SeeedDocument/Seeeduino_Arch/img/Open_Compiler.jpg

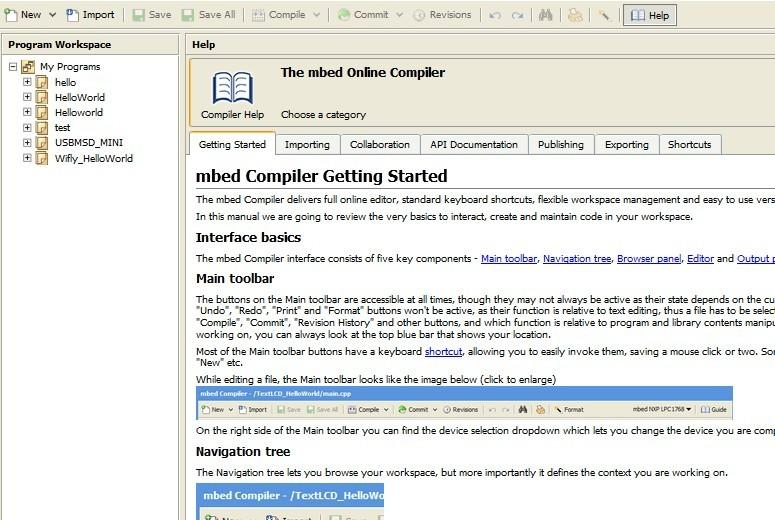
img/Open_Compiler.jpg
