SeeedDocument/Seeeduino_Arch/img/Arch_01.jpg

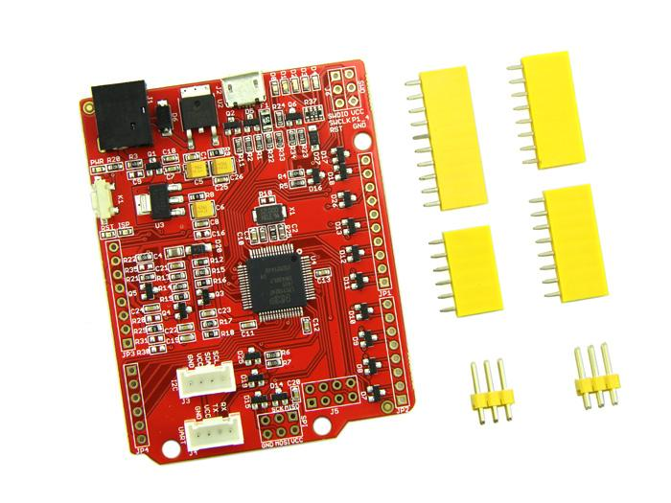
img/Arch_01.jpg
