SeeedDocument/Seeeduino_Arch/img/A_usb_device.jpg

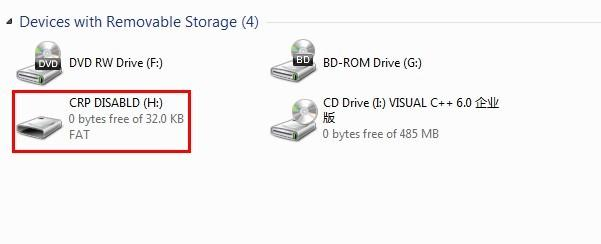
img/A_usb_device.jpg
