SeeedDocument/Seeeduino_Arch/img/Arch_Pinout.png

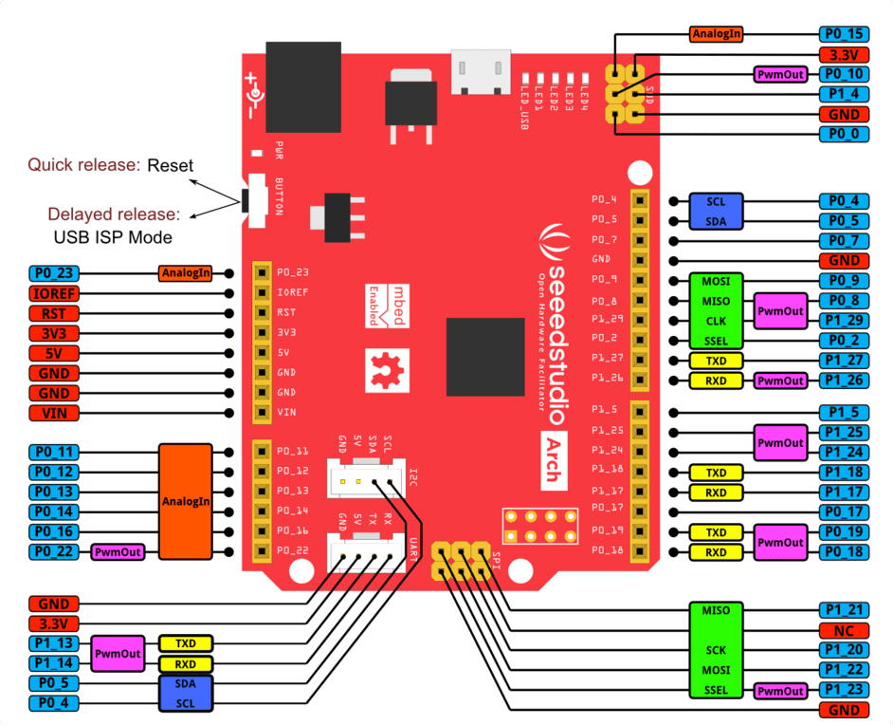
img/Arch_Pinout.png
