SeeedDocument/Seeeduino_Arch/img/Compiler.jpg

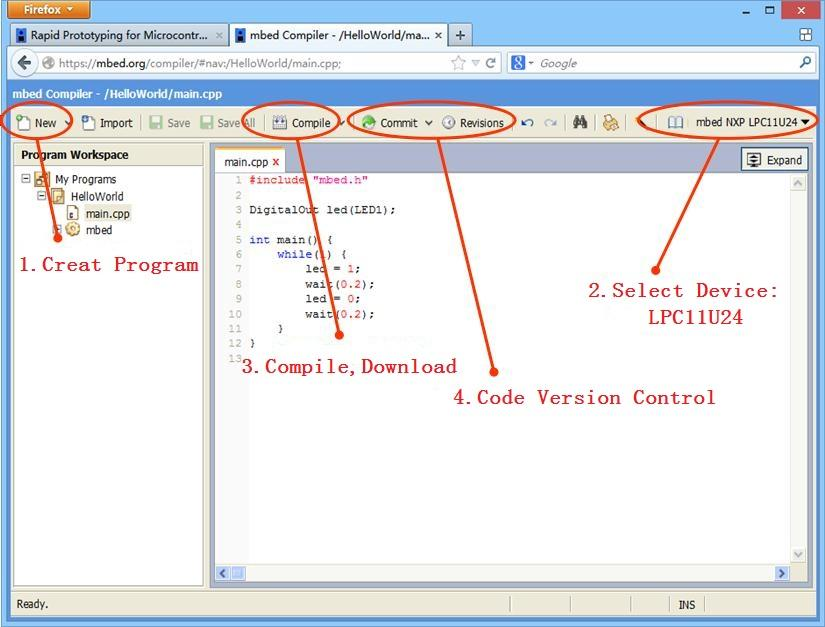
img/Compiler.jpg
