SeeedDocument/Seeeduino_Arch/img/Error_prompt.jpg

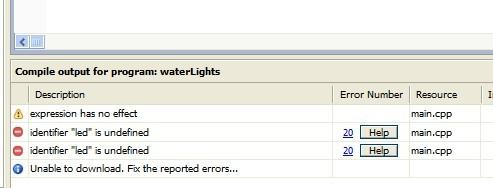
img/Error_prompt.jpg
