SeeedDocument/Seeeduino_Arch/res/Seeeduino_Arch_V1.0.pdf

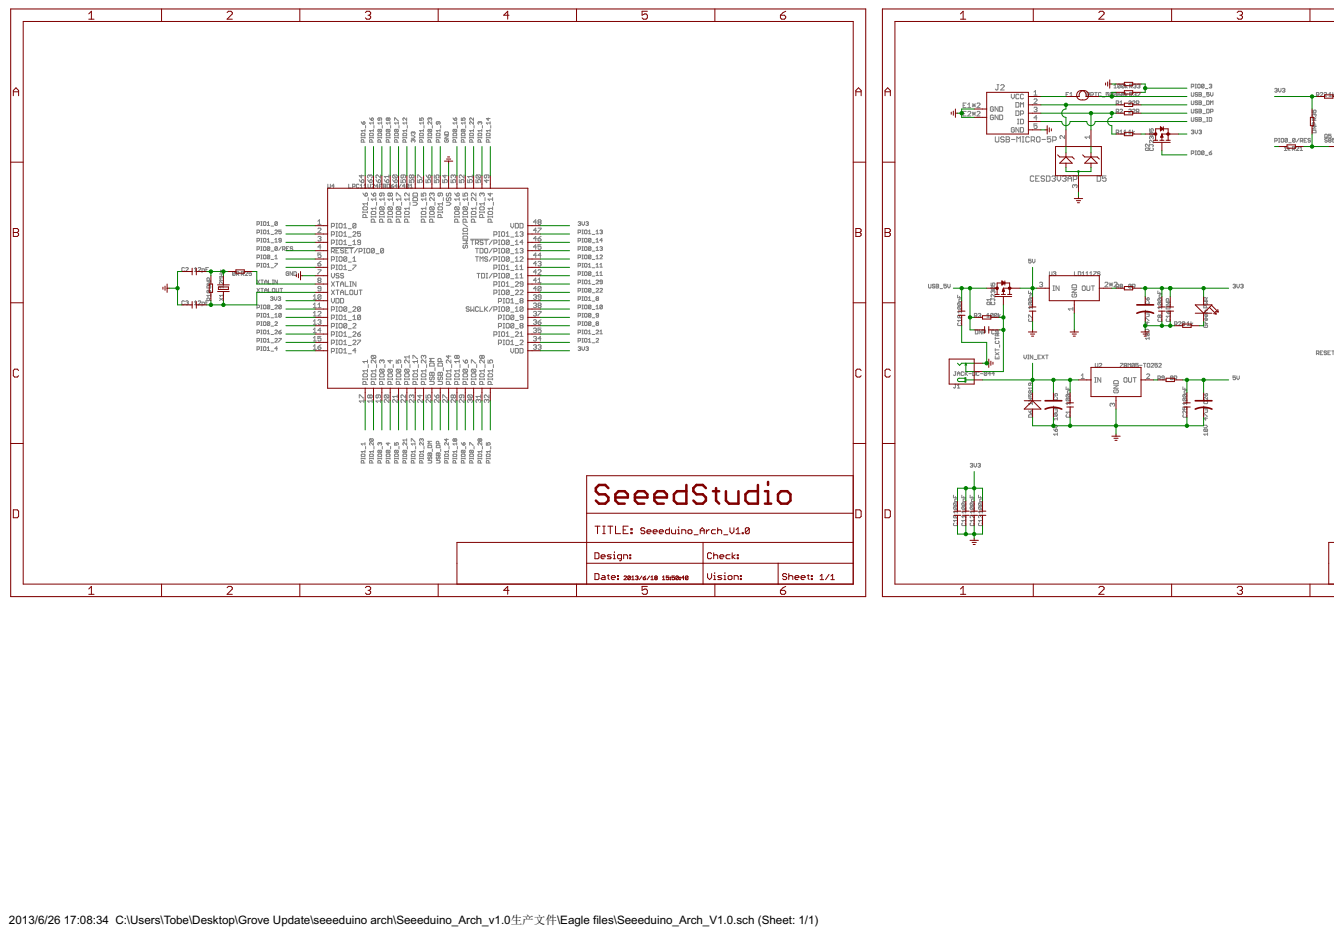
[picture p7: page 1]

2013/6/26 17:08:34 C:\Users\Tobe\Desktop\Grove Update\seeeduino arch\Seeeduino_Arch_v1.0生产文件\Eagle files\Seeeduino_Arch_V1.0.sch (Sheet: 1/1)

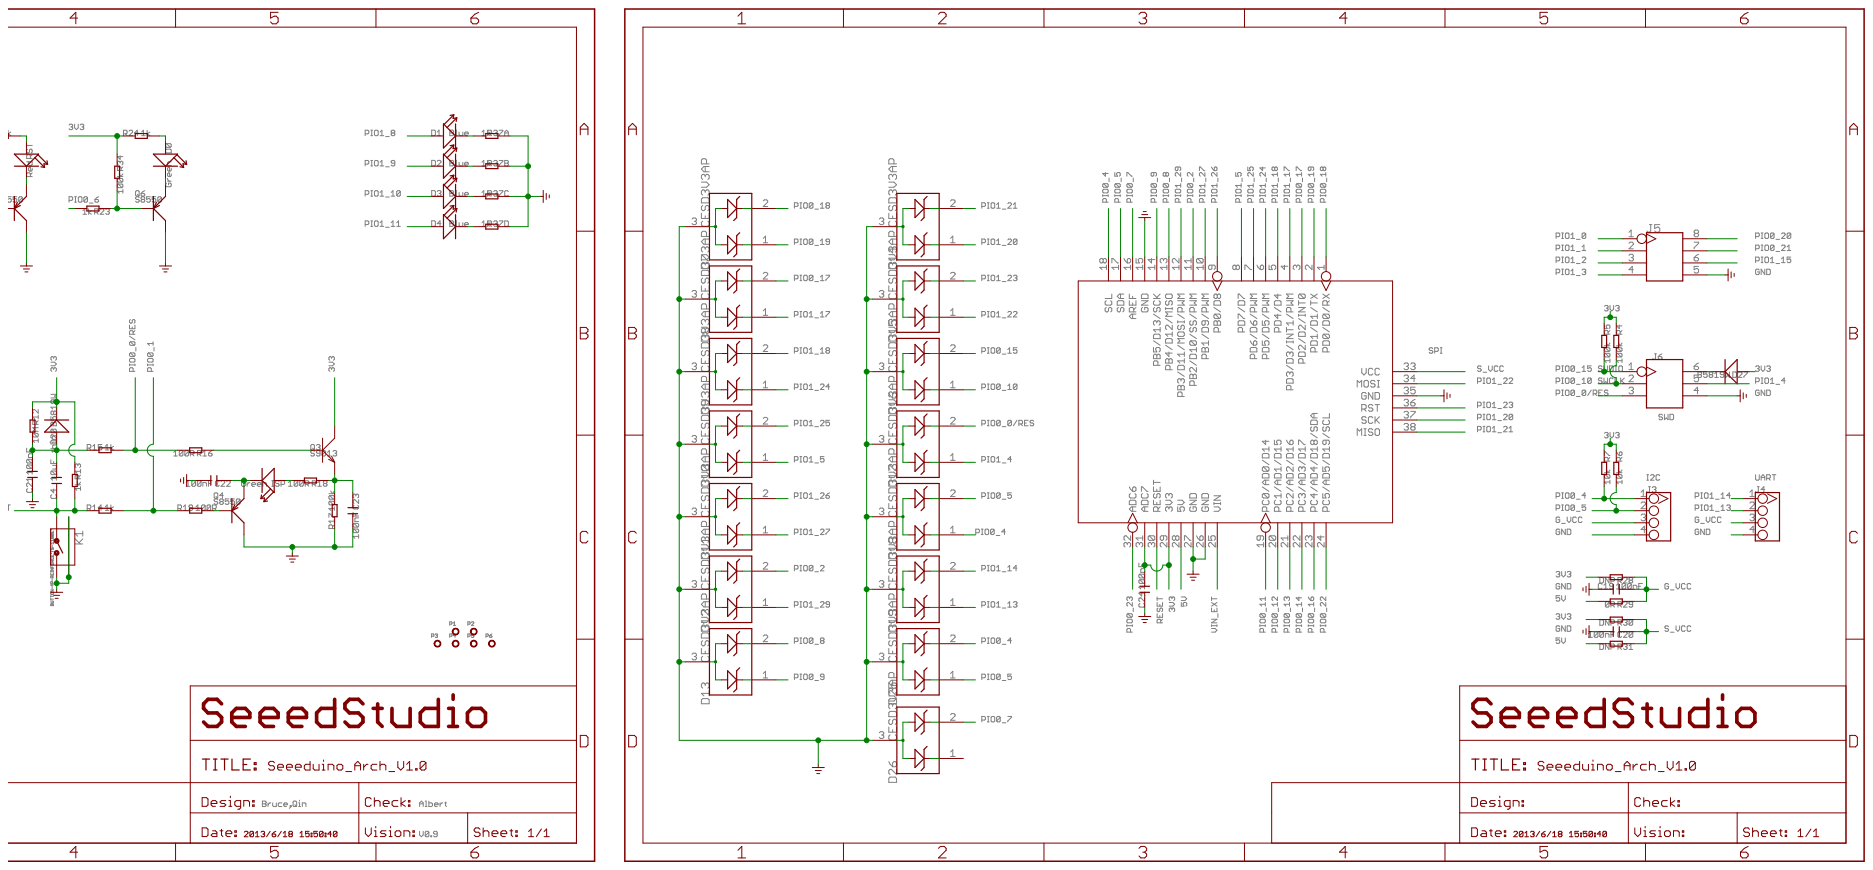
[picture p8: page 2]
